felipercr/Geladeira-Placa-Peltier/Descrição do Projeto/Confecção da placa do Kit EXP430G2ET.pdf

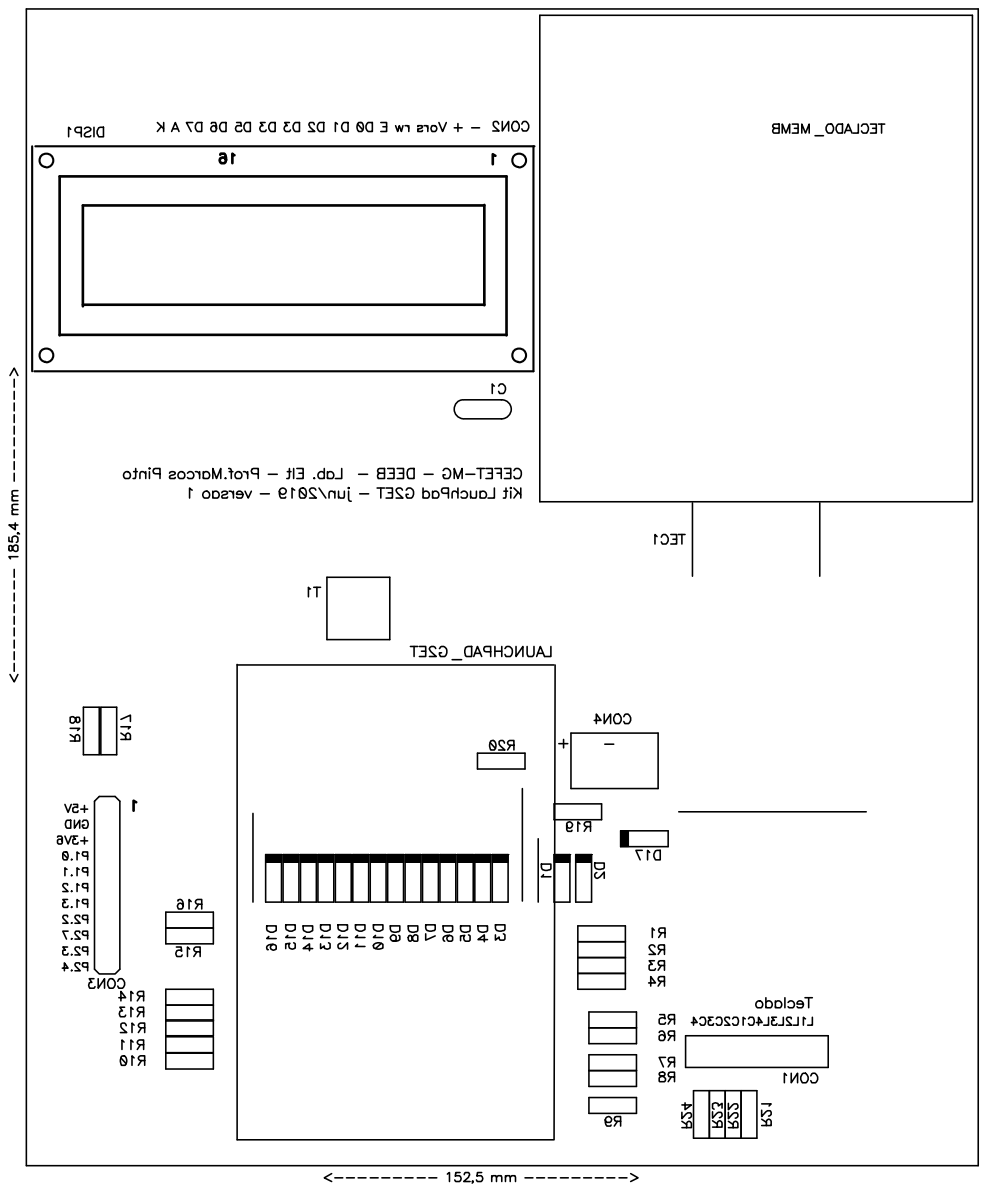
[picture p13: page 4]
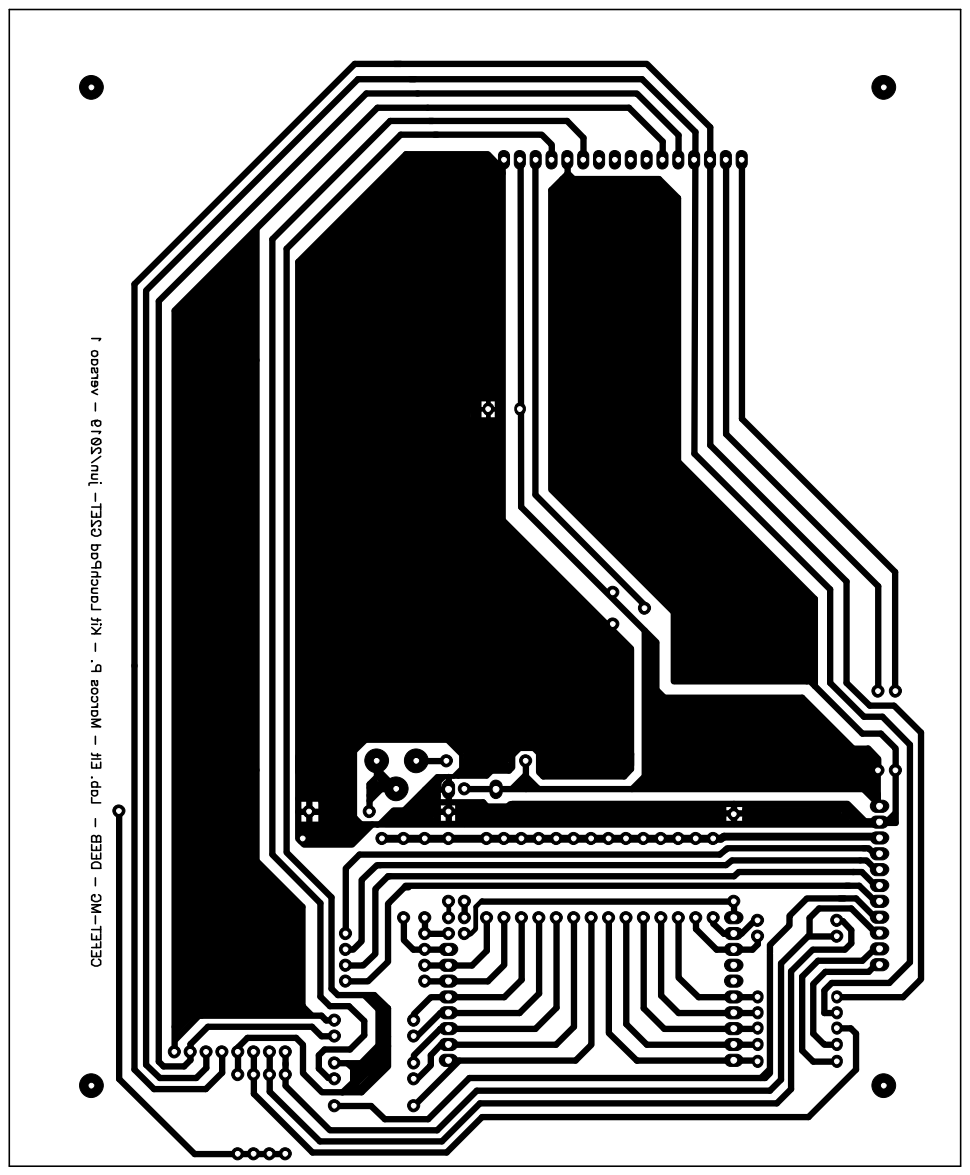
[picture p14: page 5]
